MakersAsylumIndia/IS2026_SU_Team12_FootSense/README.md

# Innovation School 2026 Summer Team 12 - FootSense

FootSense is a smart insole system that continuously monitors how weight is distributed across the foot and how each step is taken. Pressure sensors (FSRs) embedded in a gel insole, paired with a motion sensor (IMU) in a compact module, capture real-time gait and balance data. This data is sent wirelessly to a mobile device, where it's analyzed and turned into clear, actionable insights — like incorrect steps per 1000, pressure imbalance, and impact patterns — helping users improve posture, prevent injury, and refine their movement over time.
CAD - No files
Code - Two Versions for the two versions of the project - velostat and flex/piezo sensors
Electronics - Circuit Designs and Pinouts for both versions

## License

Licenses

<a href="LICENSE.md">Open Source Licenses Facts</a>

#### Hardware
CERN Open Hardware License Version 2 - Strongly Reciprocal ([CERN-OHL-S-2.0](https://spdx.org/licenses/CERN-OHL-S-2.0.html)).

#### Software
MIT open source [license](http://opensource.org/licenses/MIT).

#### Documentation:
<br />This work is licensed under a <a rel="license" href="http://creativecommons.org/licenses/by/4.0/">Creative Commons Attribution 4.0 International License</a>.

---
## [OSHWA Certification](https://certification.oshwa.org/list.html)

[OSHW] IN000101 | Certified open source hardware | oshwa.org/cert

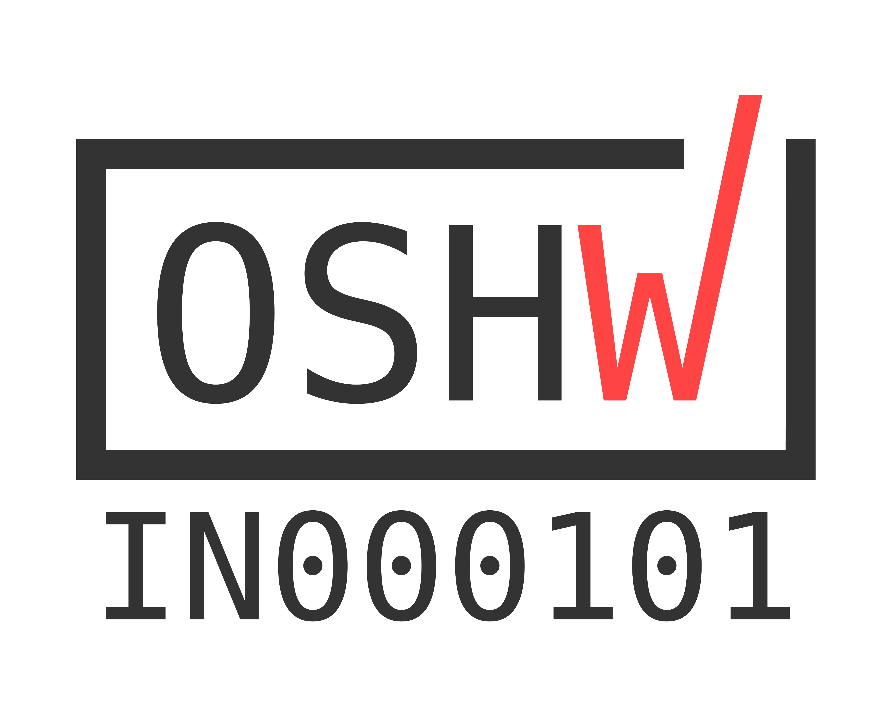
[picture p1: certification-mark-IN000101-stacked.png]


---

## 📬 Contact/Team

> _List team members and contact emails or GitHub profiles._

[Arnav Gupta](https://github.com/arnav0123-blt)

[Kiyansh Mahajan](https://github.com/kiyanshh-123)

[Kinjal Mehta](https://github.com/kinjalmehta24)

[Maker's Asylum](https://github.com/makersasylum)

[@anool](https://github.com/Anool)
>
> ---
