MakersAsylumIndia/IS2026_SU_Team12_FootSense/Documentation/Team12_FootSense.pptx

FootSense

smart insole tracker
A 10 crore rupee problem,
solved with a soldering iron

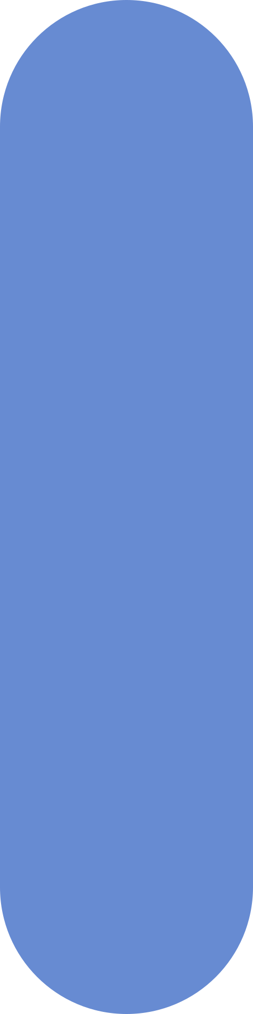
[picture p4: figure]
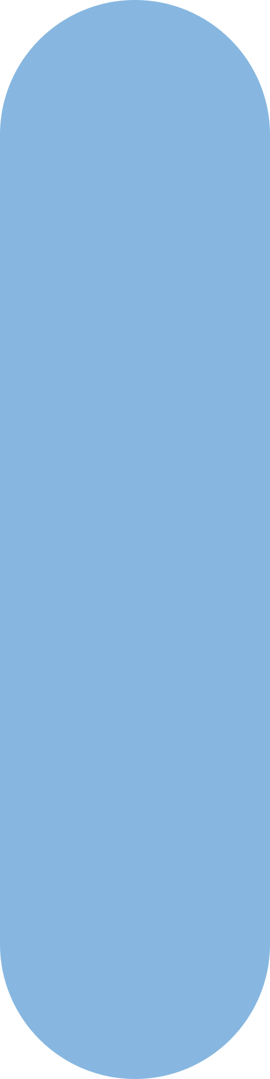
[picture p5: figure]
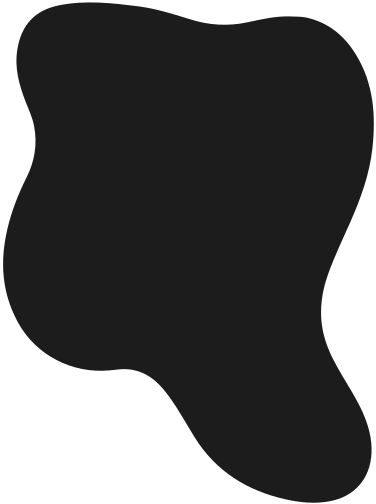
[picture p6: figure]
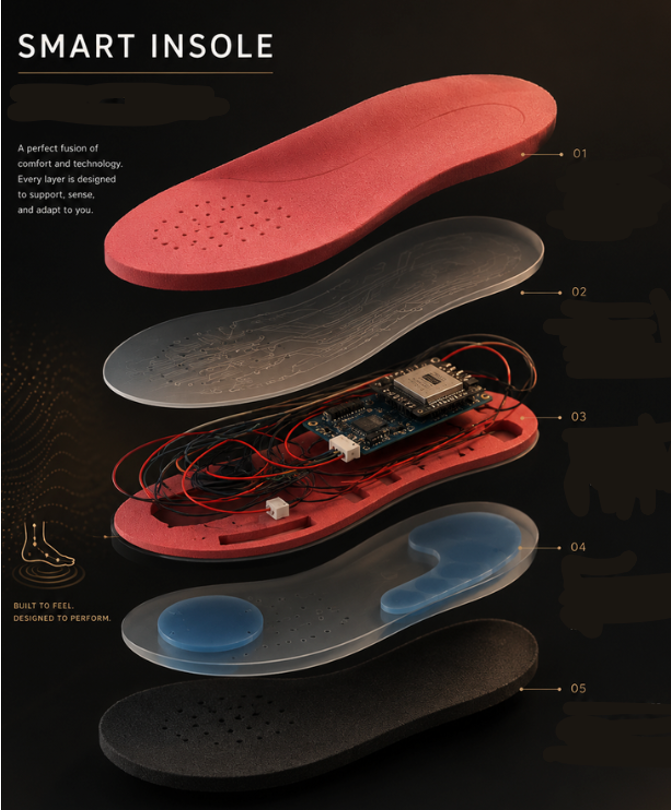
[picture p7: figure]

By: Arnav Gupta
Kinjal Mehta
Kiyansh Mahajan

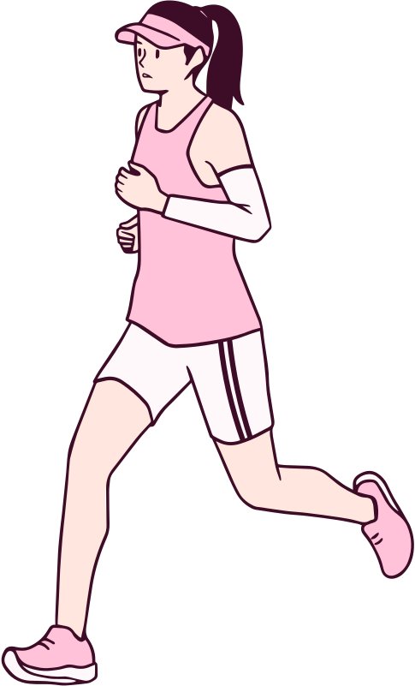
[picture p8: figure]
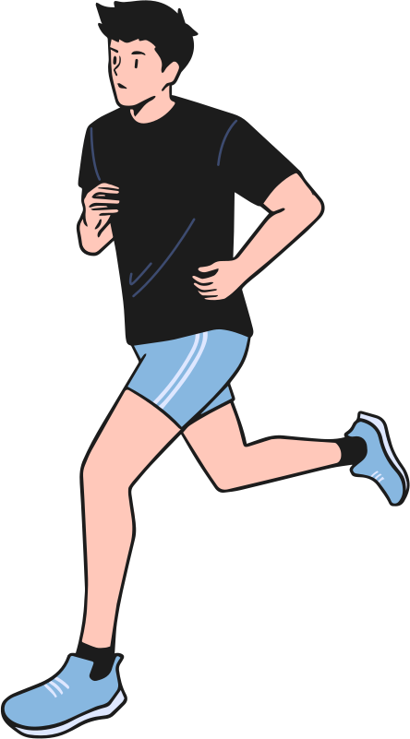
[picture p9: figure]
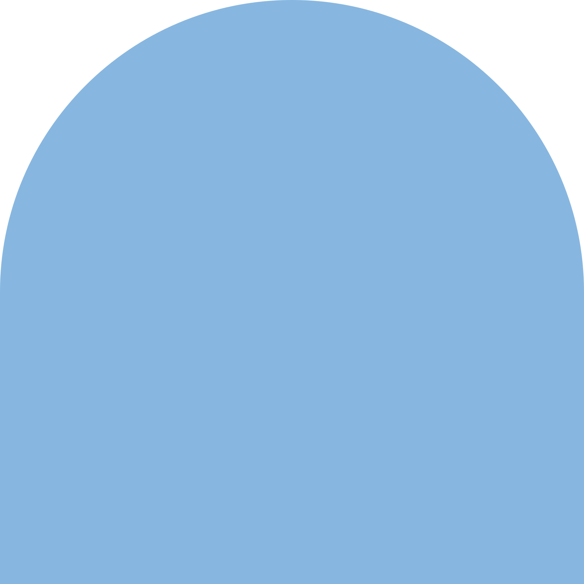
[picture p10: figure]

## Slide 2

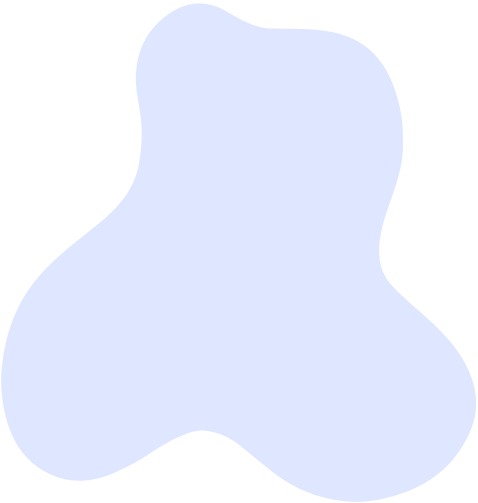
[picture p11: figure]
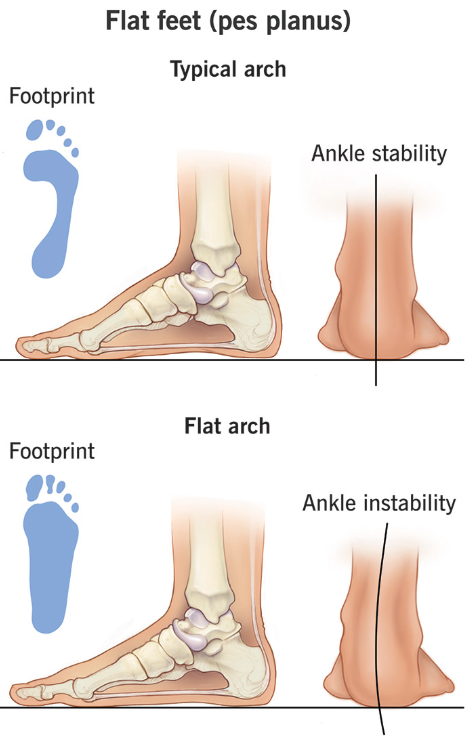
[picture p12: figure]

The Problem

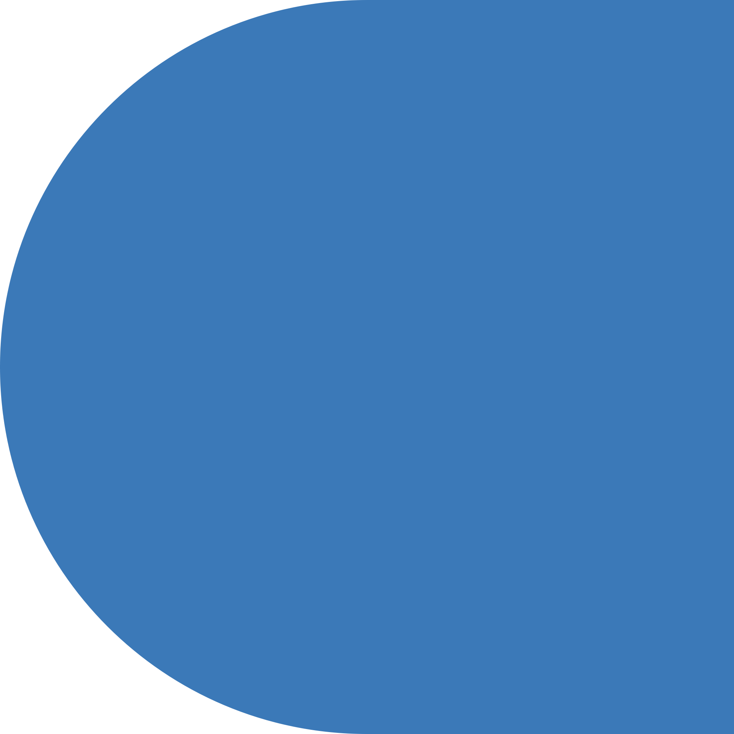
[picture p13: figure]

9–18% of Indians show flat feet, depending on which clinical test you use

One study of traffic police in Gujarat found flat feet in 33–34% of officers — mostly from standing all day

24.8% prevalence found in a Delhi hospital screening study

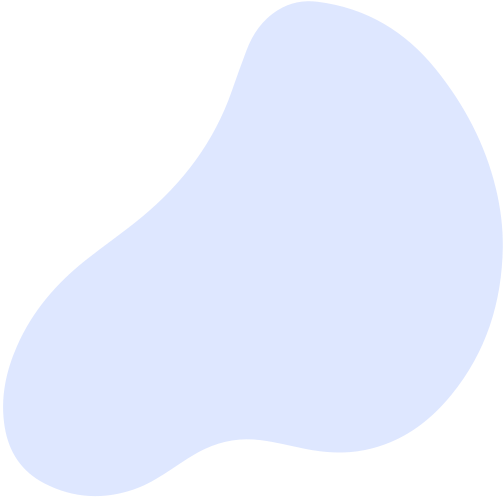
[picture p14: figure]
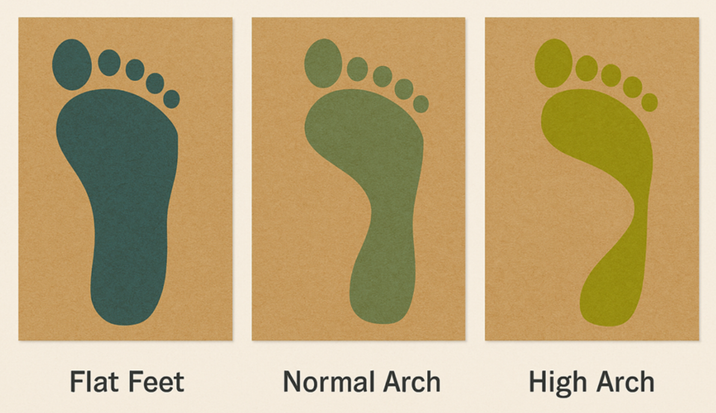
[picture p15: figure]

## Slide 3

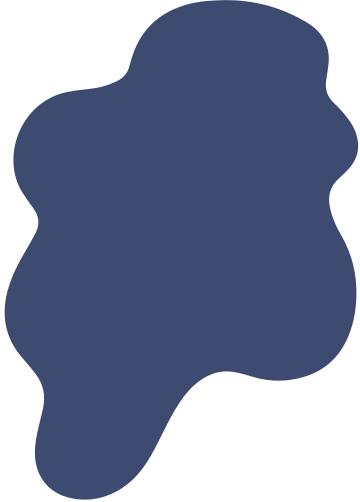
[picture p16: figure]

The Expensive Way

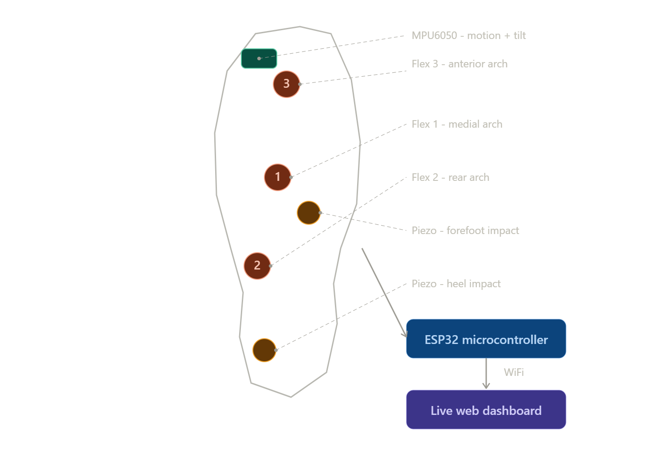
[picture p17: figure]

Clinical Gait Analysis System

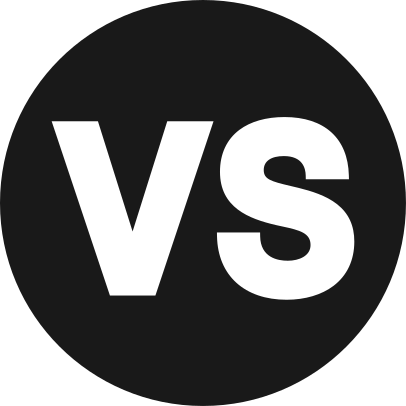
[picture p18: figure]

FootSense

3D Gait Analysis System: ₹10,00,000+
FootSense: a few hundred rupees in sensors and a Sunday at Maker's Asylum

## Slide 4

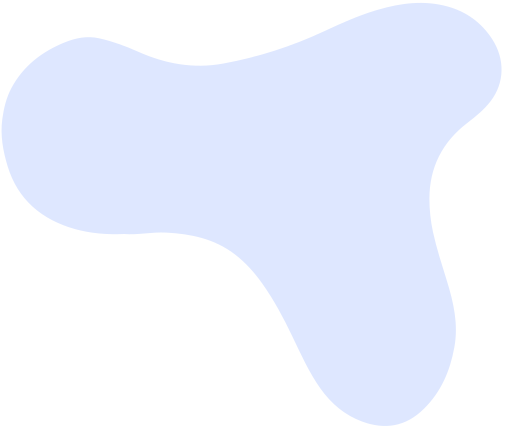
[picture p19: figure]
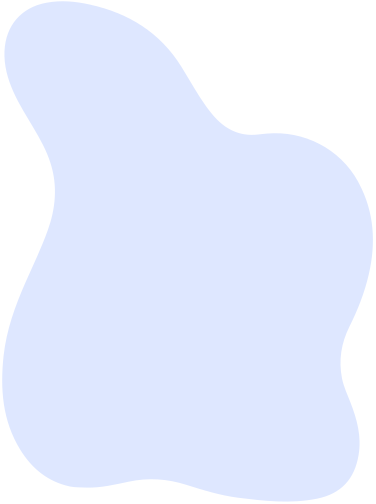
[picture p20: figure]
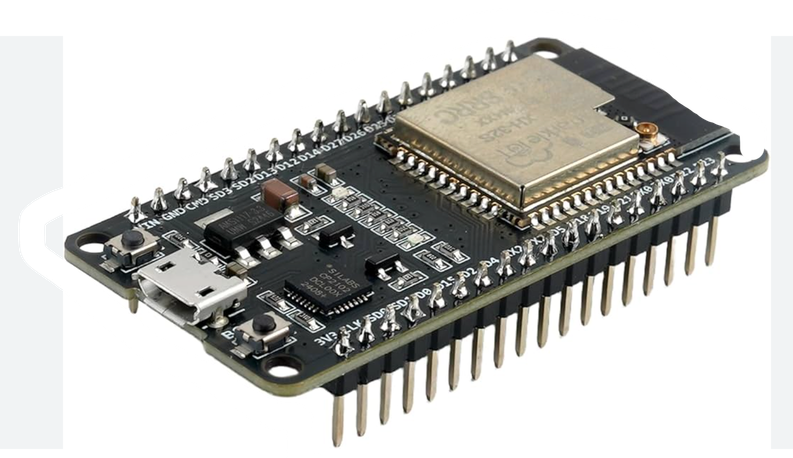
[picture p21: figure]
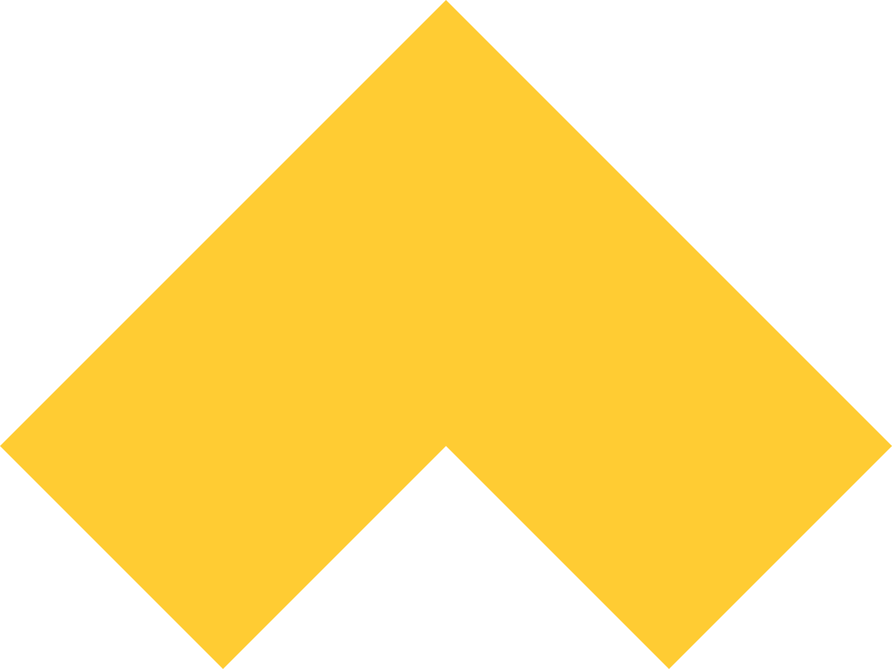
[picture p22: figure]
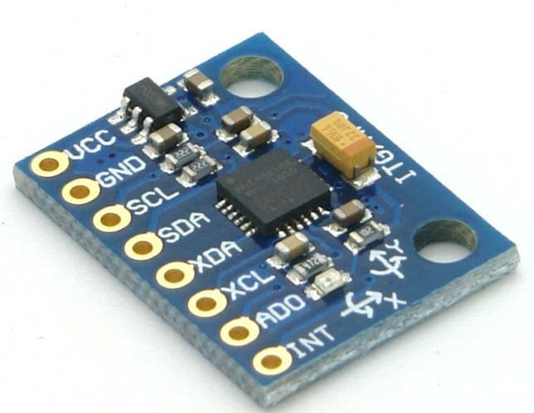
[picture p23: figure]

What’s Actually in the Shoe

  - 3 flex sensors → arch shape (flat / normal / high)
  - 2 piezo discs → heel & forefoot impact
  - MPU6050 → step count & impact angle
  - ESP32 → WiFi → live dashboard

ESP32

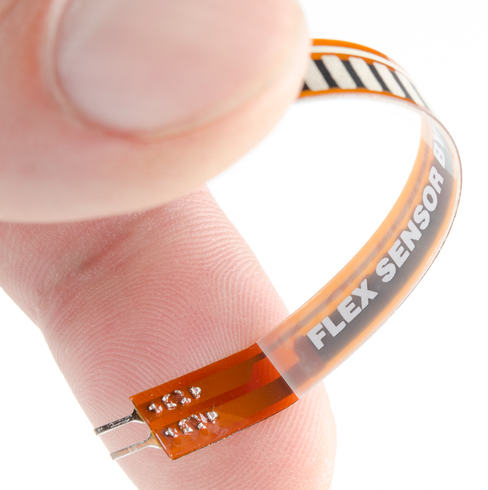
[picture p24: figure]
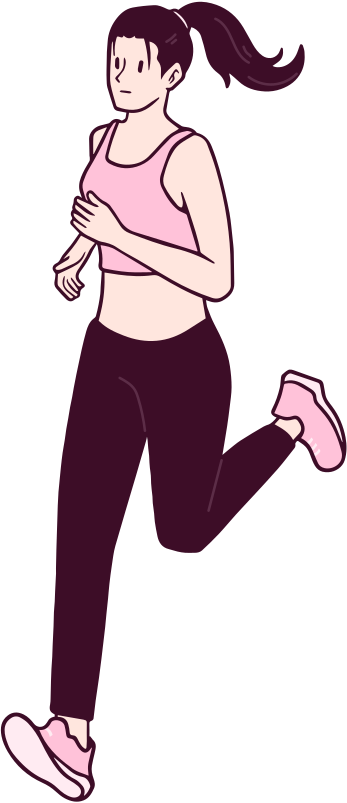
[picture p25: figure]

MPU6050

flex sensor

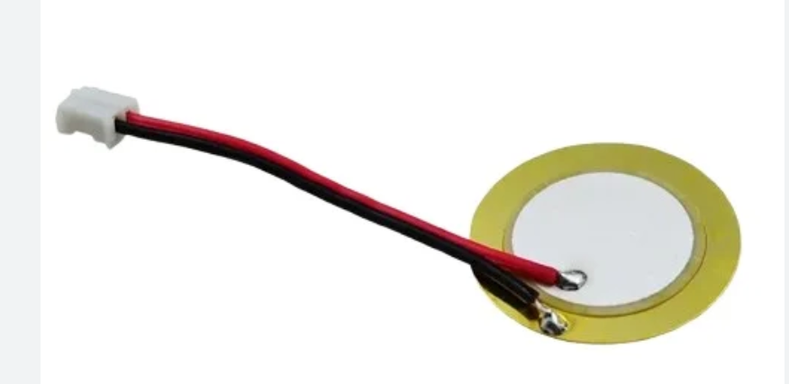
[picture p26: figure]

piezo disc

## Slide 5

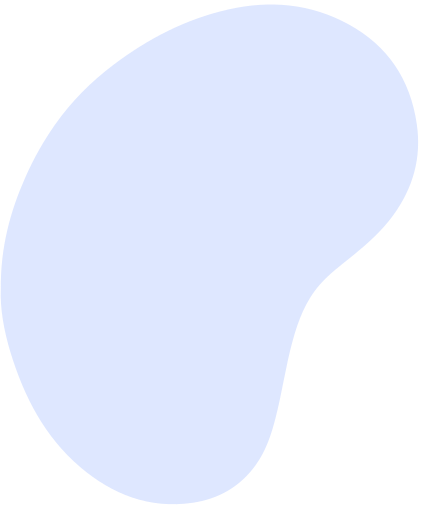
[picture p27: figure]
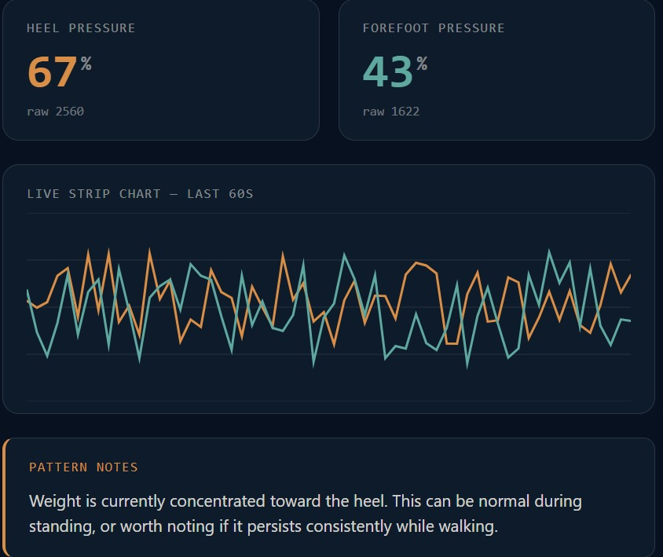
[picture p28: figure]

It Talks Back

Live Dashboard

Real Time Arch Bend

Foot Diagnosis

Impact Pressure (Graph and Data)

Step Count + Impact Angle

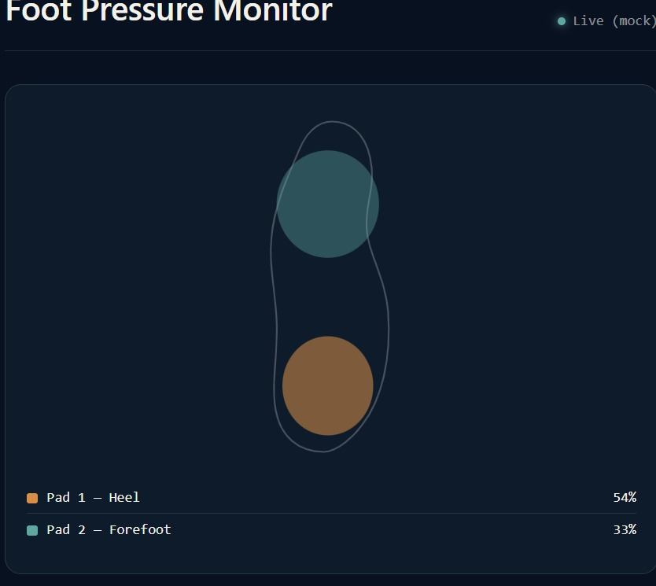
[picture p29: figure]
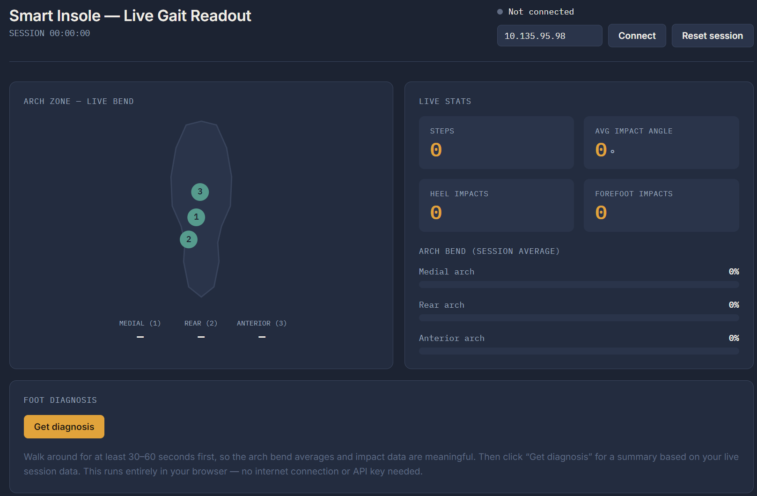
[picture p30: figure]

## Slide 6

## Slide 7

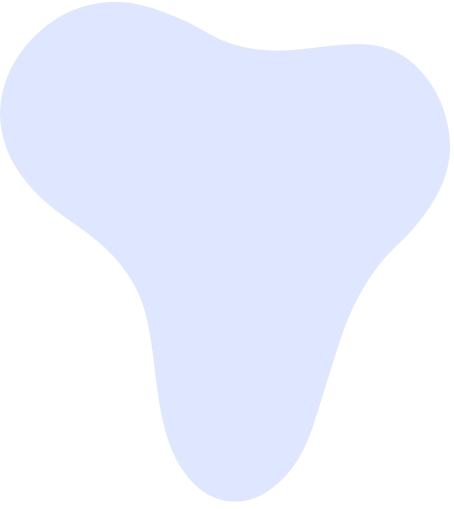
[picture p31: figure]
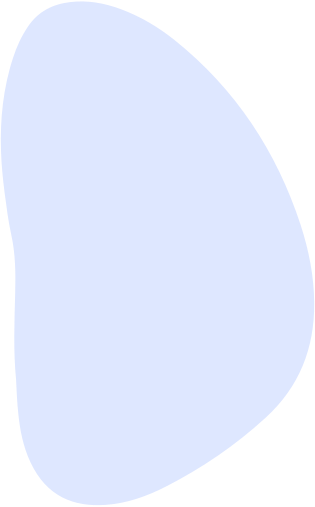
[picture p32: figure]
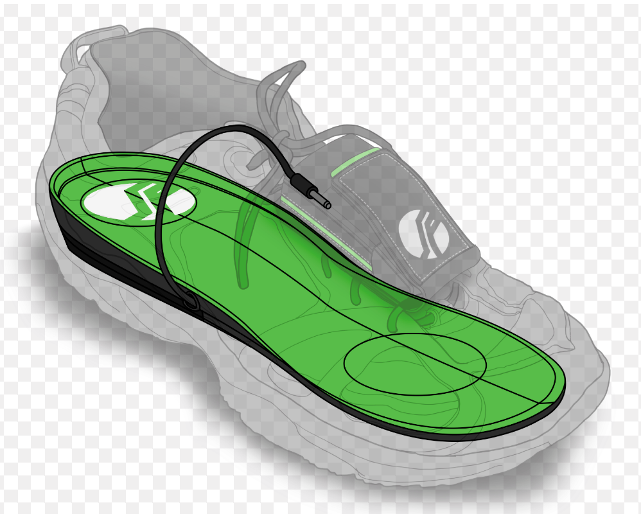
[picture p33: figure]

The Truth

  - Load cell + 4-sensor bridge: didn't work, never fully diagnosed why
  - Switched to flex sensors + piezo discs/velostat instead
  - Chased ghost GPIO pins across three different boards
  - Eventually got a working ESP32 + WiFi + live dashboard pipeline

## Slide 8

The Velostat Version

  - Pressure-sensitive sheet, not discrete sensors
  - Resistance drops the harder you press — wired as a simple voltage divider
  - Gives a continuous pressure map instead of fixed points
  - Closer to what ₹10,00,000 clinical mats actually do
  - Tradeoff: more finicky to calibrate consistently
  - Built in parallel — not a replacement, a second real path

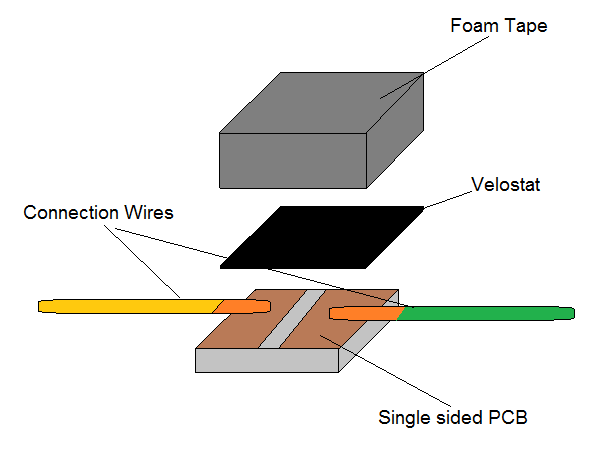
[picture p34: figure]

## Slide 9

The Truth Again

Honest Limitations

  - This is a relative signal, not a medical diagnosis
  - Tested on one person, on one foot.

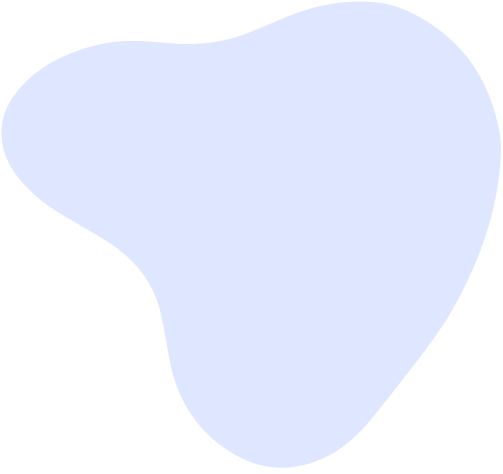
[picture p35: figure]
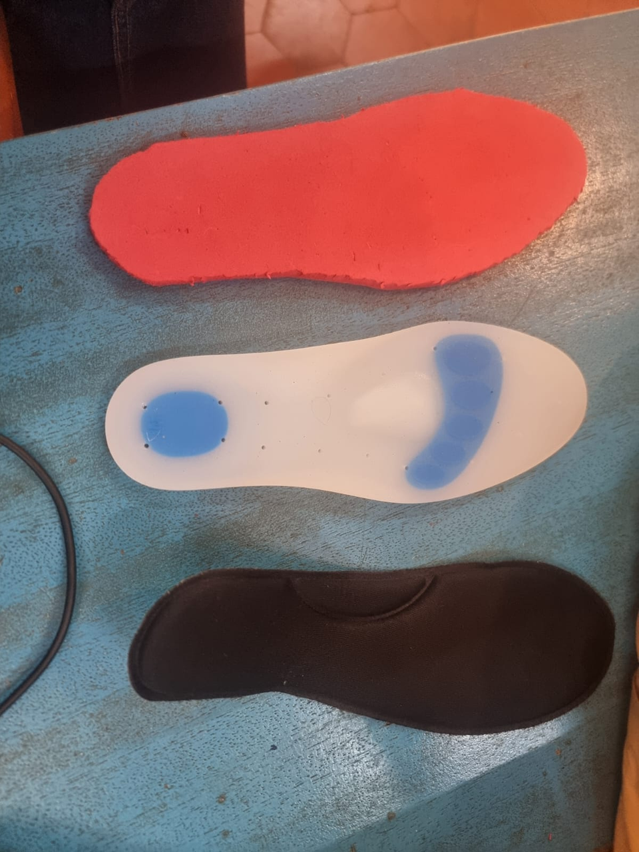
[picture p36: figure]
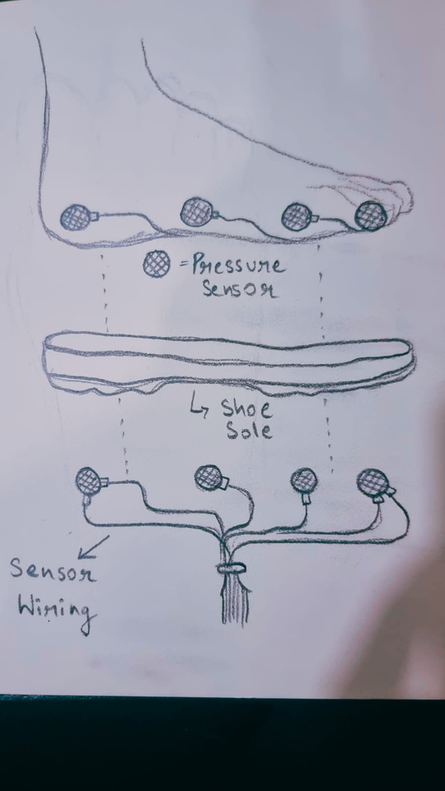
[picture p37: figure]
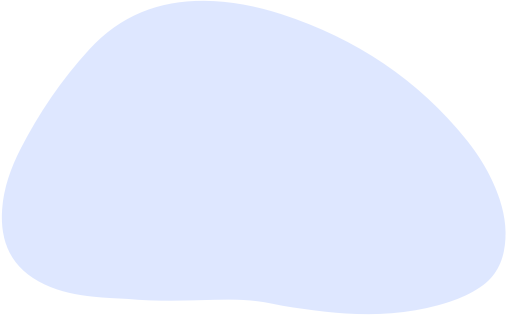
[picture p38: figure]

## Slide 10

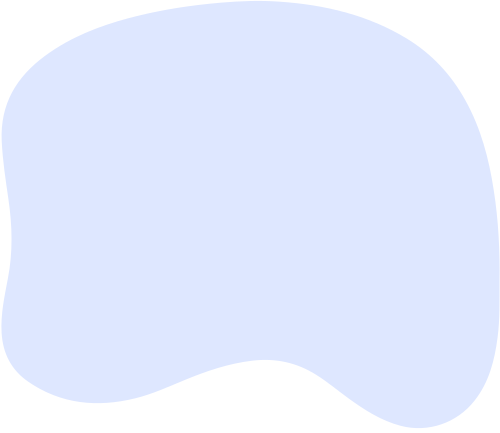
[picture p39: figure]

Roadmap

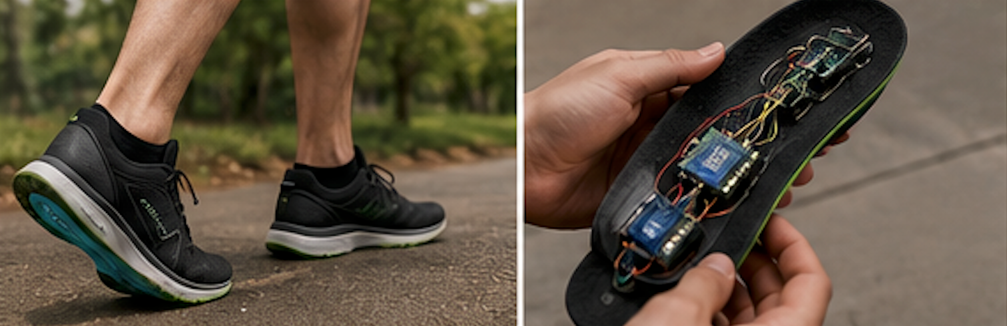
[picture p40: figure]

Q1 Development

Finalize innovative product design and successfully complete precise sensor calibration process. Design a finalised protected prototupe and apply for a license,

Q2 Testing

Testing the product and collecting data. Doing further extensive research and training a neural network to develop an AI/ML finished software. Connect with doctors, share the data and use their feedback.

Q3 Awareness

Launch the product on a small scale, connect with shoe/footwear giants and look to expand the product’s functionality and make more iterations.

## Slide 11

FootSense

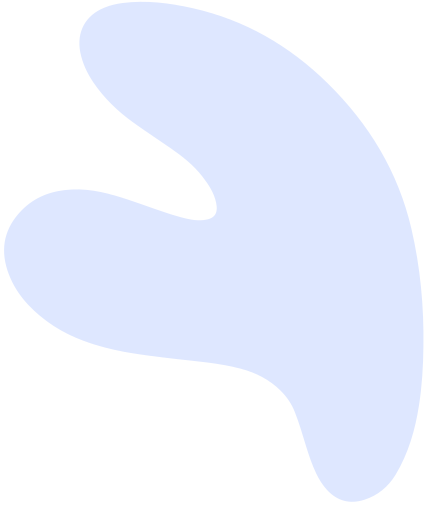
[picture p41: figure]
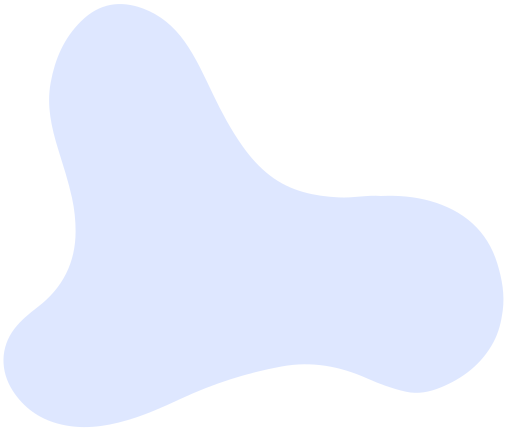
[picture p42: figure]

Lab-grade insight. Maker-grade budget. Blood. Sweat. Tears. A LOT of work. Even more help from mentors.
Questions?

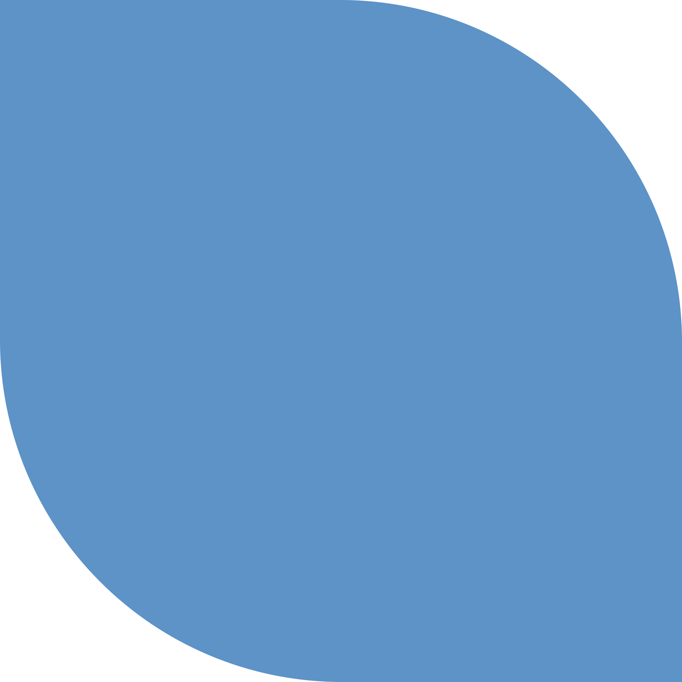
[picture p43: figure]

## Slide 12

People We Want to Thank

The amazing teammates we had here.
The ENTIRE Maker Team:
Dakshat Sir
Anool Sir
Vaibhav Sir
Miss Amber
Miss Sushmita
Sahil Sir
Miss Richa
Sankalp
Kinshuk
Sovam
Gunjan
All Our friends here, and Makers Asylum

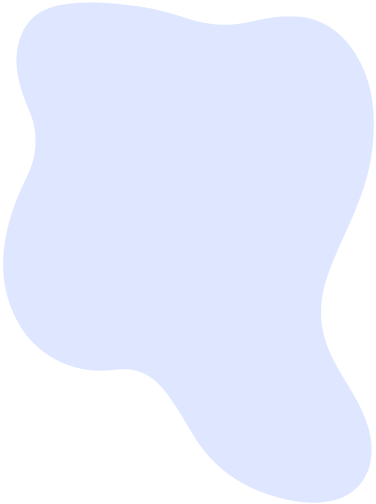
[picture p44: figure]

Simran
Adishi
Shyam
Bhoomika
Arjun
Jastin / Kalki 01
Sebi

for watching and always supporting us

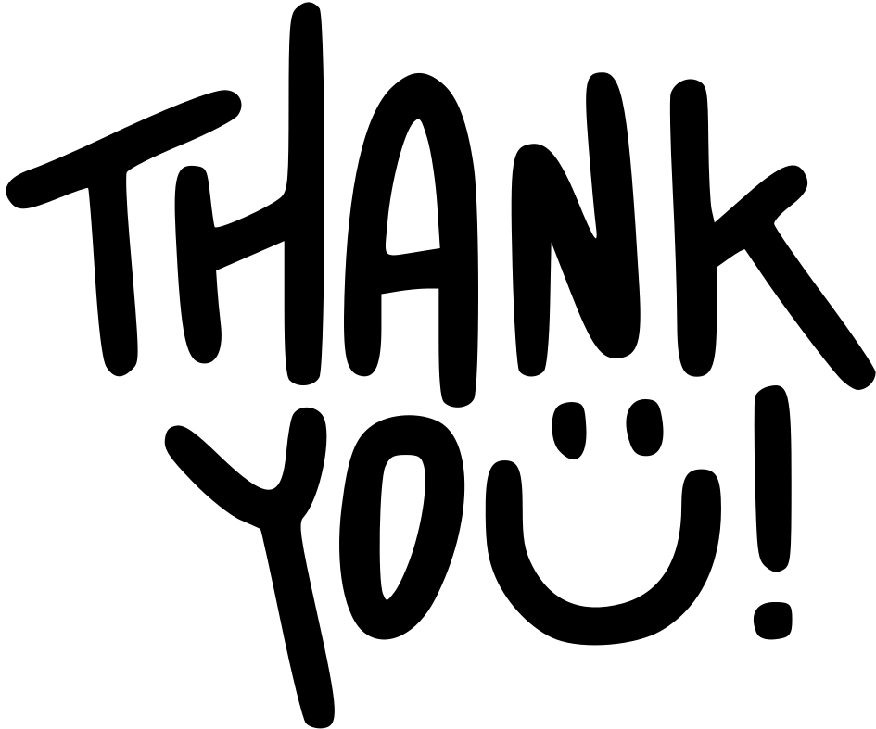
[picture p45: figure]
