MakersAsylumIndia/IS2026_SU_Team12_FootSense/Electronics/PinOuts/FlexSensor PinOut.webp

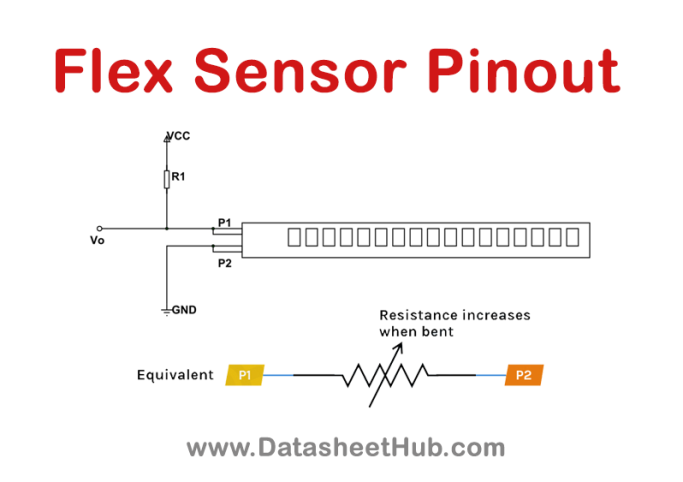
Electronics/PinOuts/FlexSensor PinOut.webp
