MakersAsylumIndia/IS2026_SU_Team12_FootSense/Electronics/PinOuts/MPU6050IMU PinOut.png

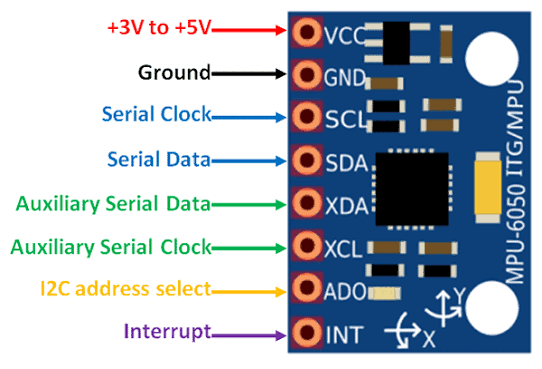
Electronics/PinOuts/MPU6050IMU PinOut.png
