MakersAsylumIndia/IS2026_SU_Team12_FootSense/Electronics/PinOuts/PiezoPinOut.png

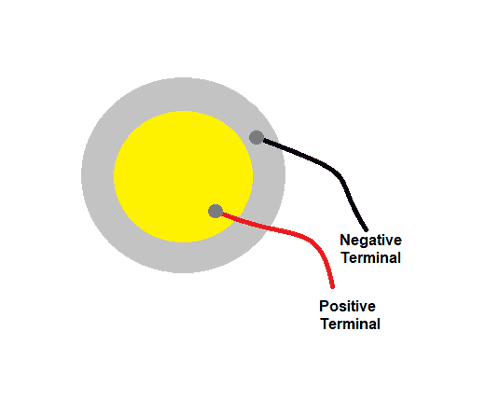
Electronics/PinOuts/PiezoPinOut.png
