MakersAsylumIndia/IS2026_SU_Team12_FootSense/Electronics/PinOuts/Velostat PinoUt.png

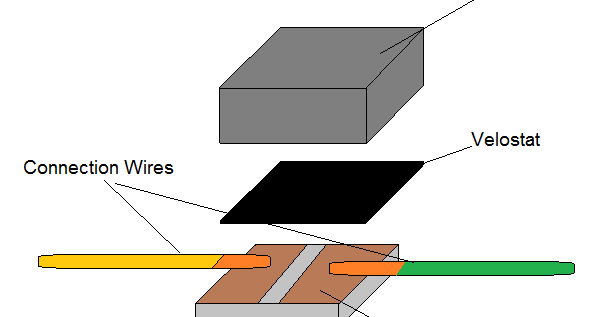
Electronics/PinOuts/Velostat PinoUt.png
