MakersAsylumIndia/IS2026_SU_Team12_FootSense/Electronics/Velostat Circuit/arduino nano cirkitdesign velostat.jpeg

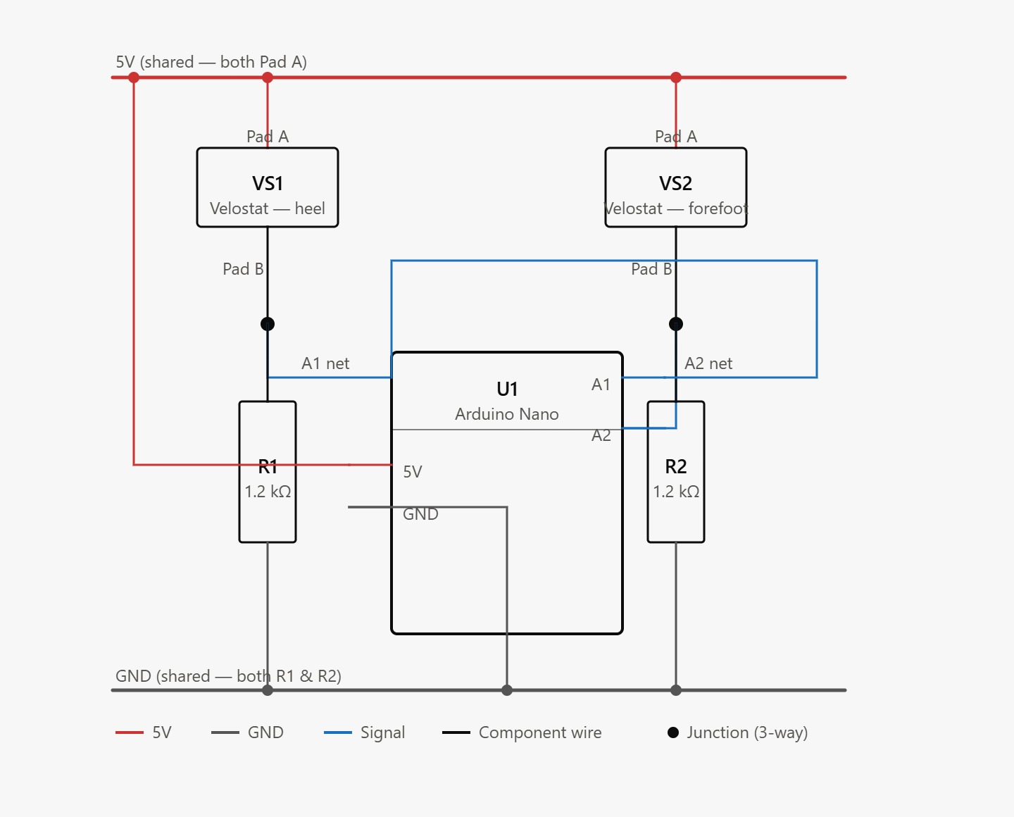
Electronics/Velostat Circuit/arduino nano cirkitdesign velostat.jpeg
