MakersAsylumIndia/IS2026_SU_Team12_FootSense/Electronics/Velostat Circuit/esp32 cirkitdesign velostat.jpeg

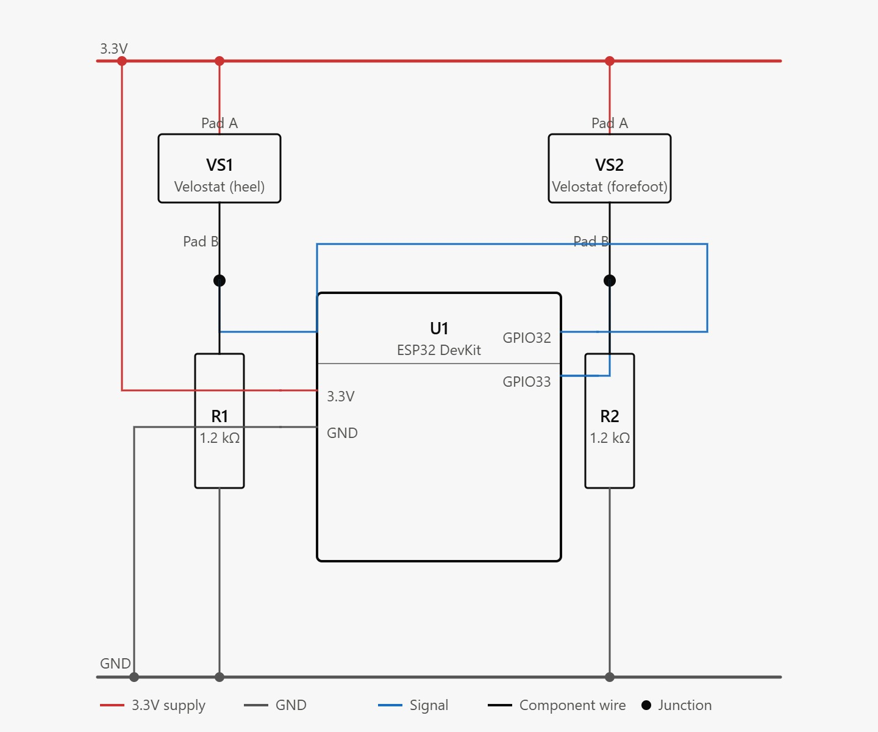
Electronics/Velostat Circuit/esp32 cirkitdesign velostat.jpeg
