MakersAsylumIndia/IS2026_SU_Team12_FootSense/Photos_Videos/Images/Team12_FootSense_03.jpeg

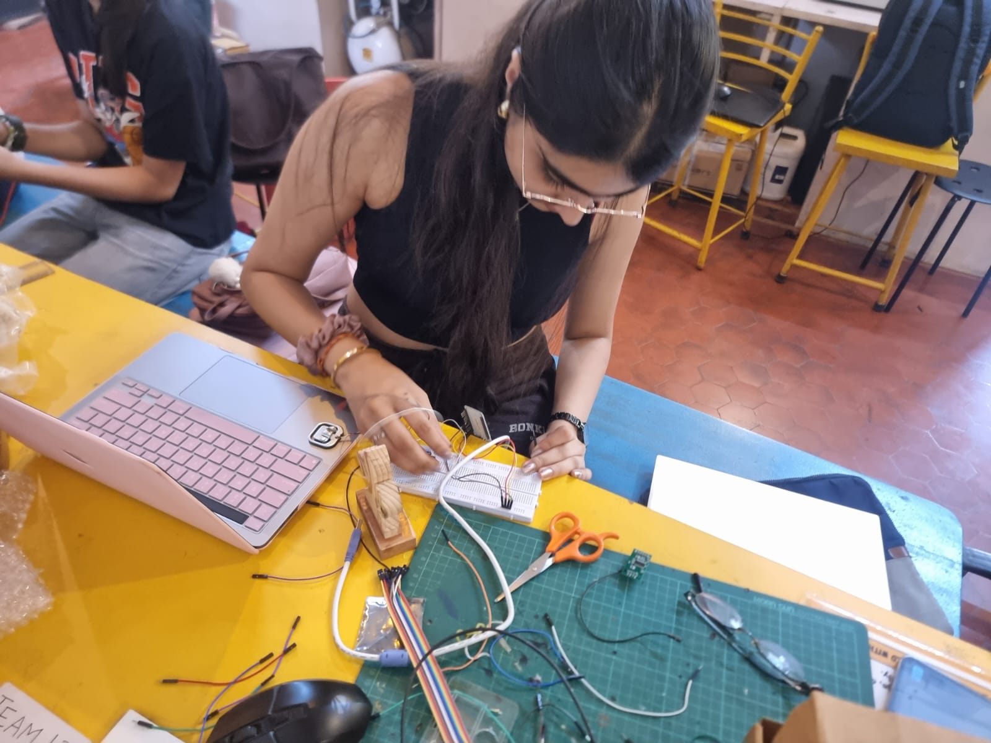
Photos_Videos/Images/Team12_FootSense_03.jpeg
