MakersAsylumIndia/IS2026_SU_Team12_FootSense/Documentation/Team12_FootSense.pdf

# FootSense

## smart insole tracker

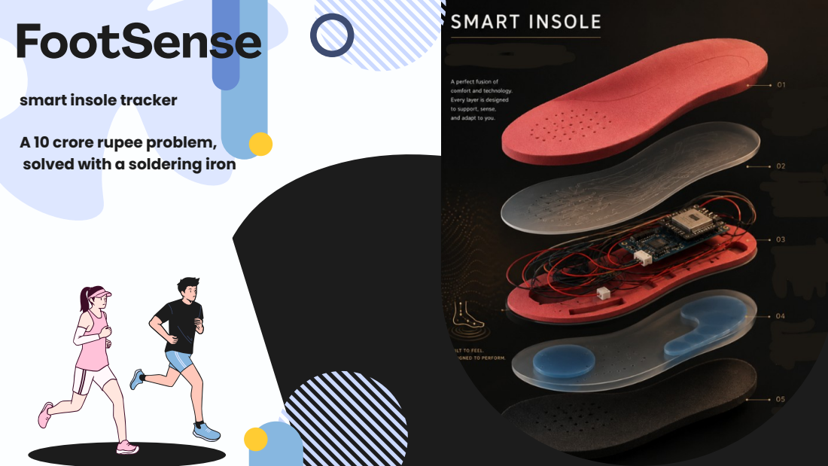
[picture p64: page 1]

A 10 crore rupee problem,
solved with a soldering iron

By: Arnav Gupta
Kinjal Mehta
Kiyansh Mahajan

# The Problem

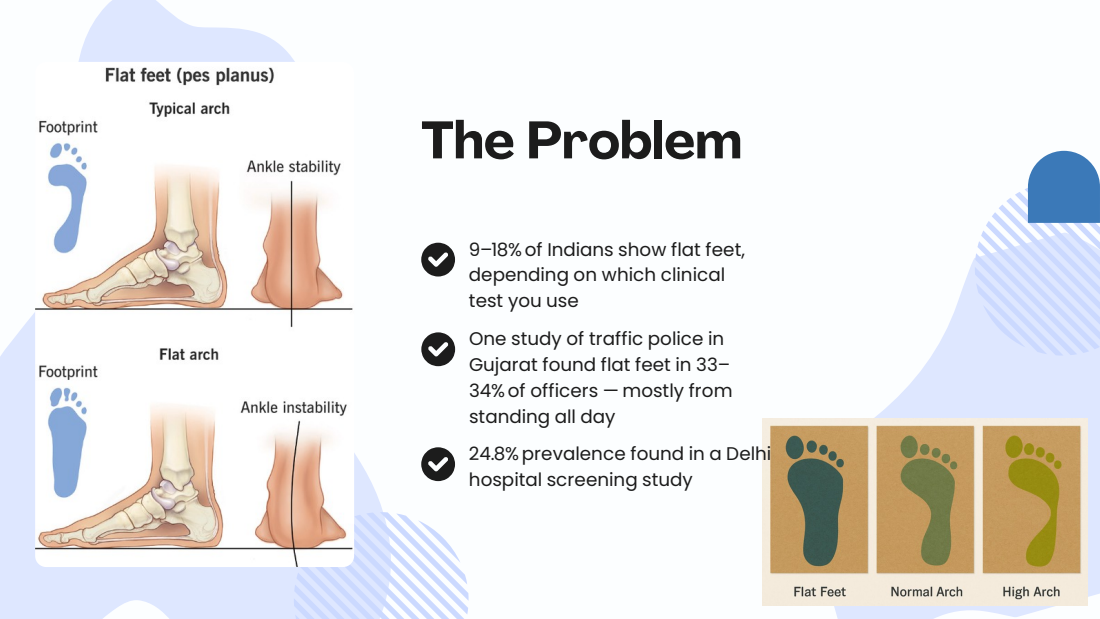
[picture p65: page 2]
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

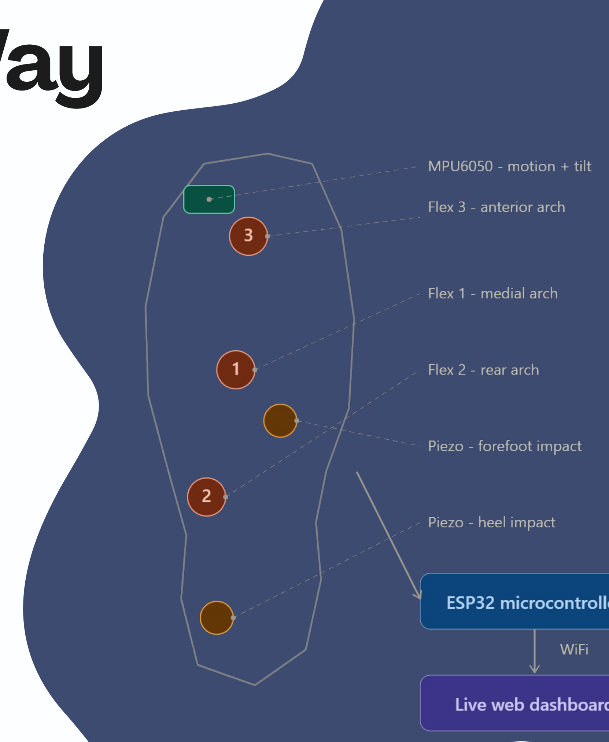
[picture p66: figure]

# The Expensive Way

# Clinical Gait Analysis System

# FootSense

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

# What’s Actually

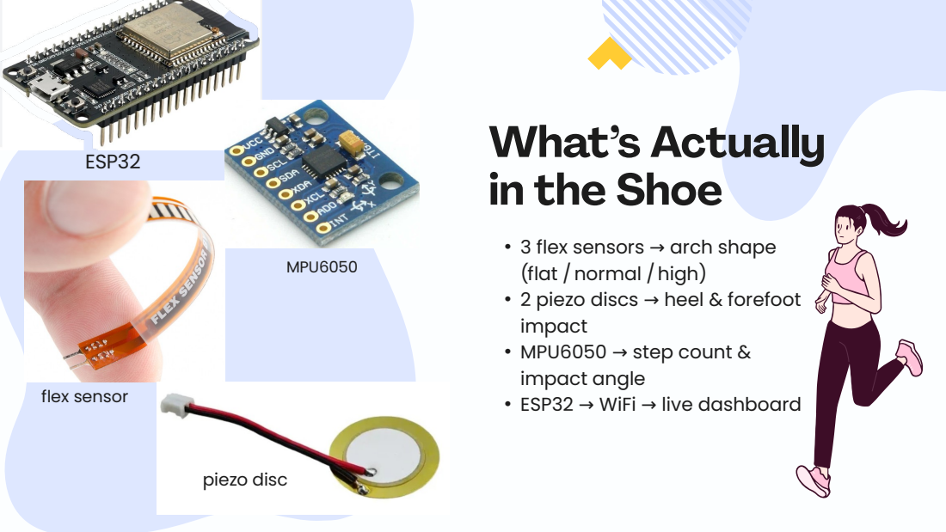
[picture p67: page 4]
• ESP32 WiFi live dashboard →; ESP32; MPU6050; flex sensor; piezo disc

in the Shoe

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

# It Talks Back

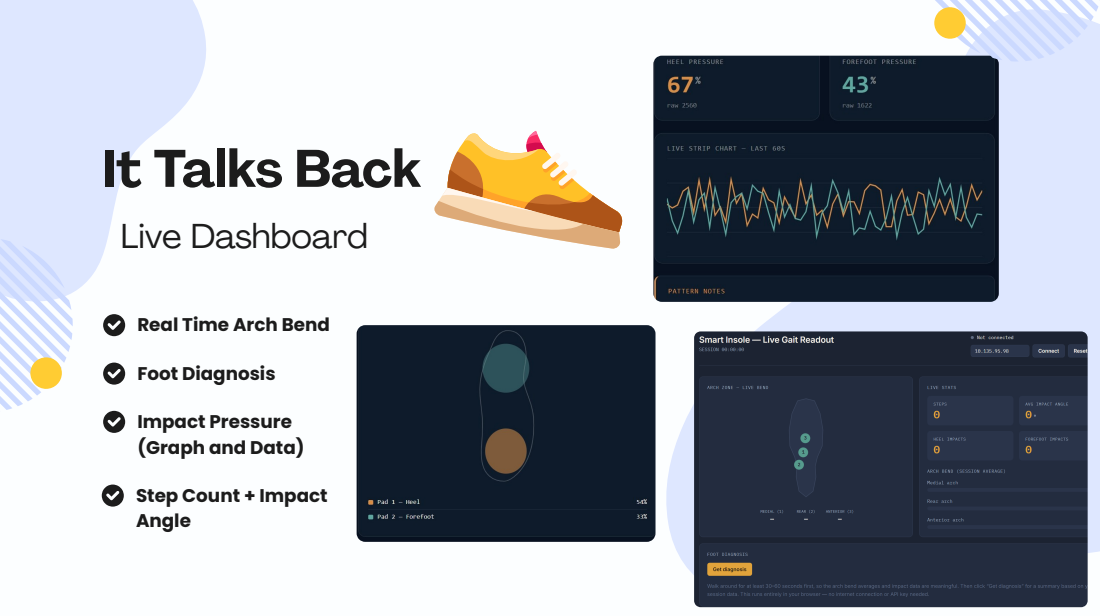
[picture p68: page 5]
Live Dashboard

Real Time Arch Bend
Foot Diagnosis
Impact Pressure
(Graph and Data)
Step Count + Impact
Angle

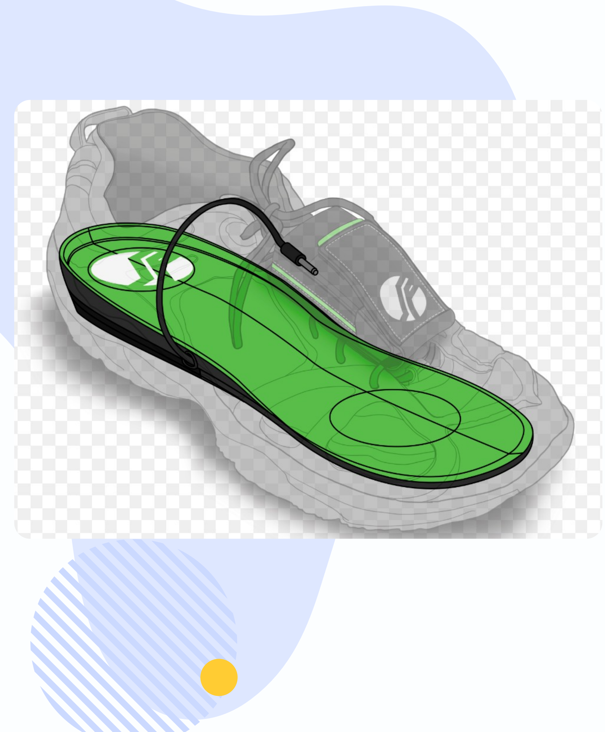
[picture p69: figure]

# The Truth

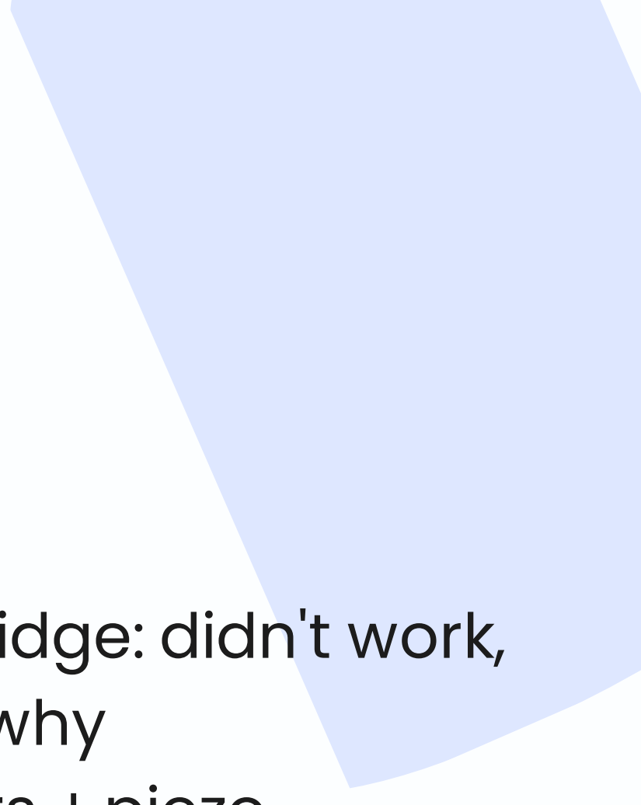
[picture p70: figure]

- Load cell + 4-sensor bridge: didn't work,

## never fully diagnosed why - Switched to flex sensors + piezo discs/velostat instead - Chased ghost GPIO pins across three different boards - Eventually got a working ESP32 + WiFi + live dashboard pipeline

## - Pressure-sensitive sheet, not discrete sensors - Resistance drops the harder you press —

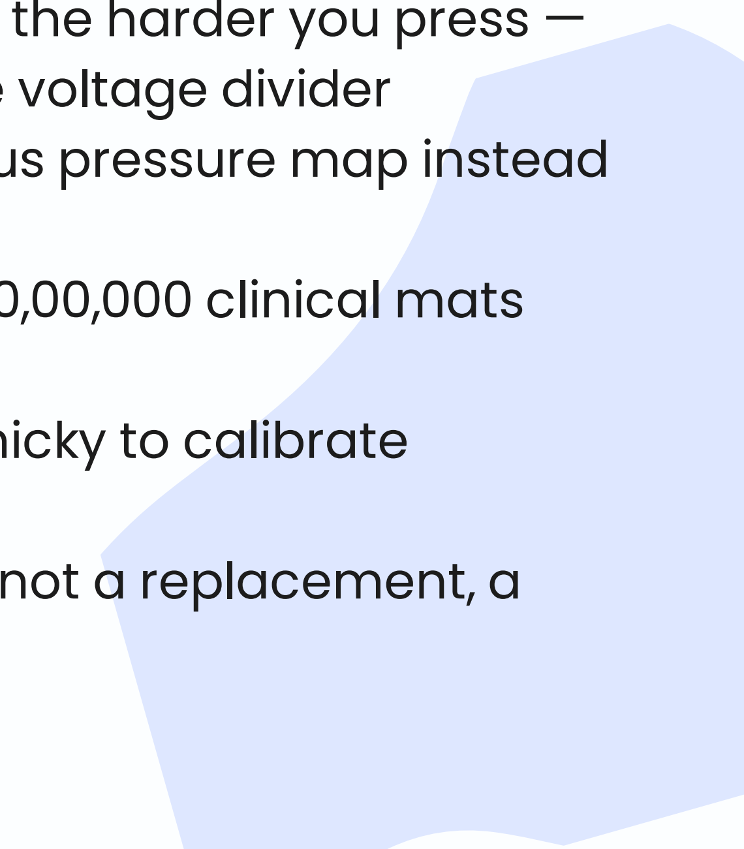
[picture p71: figure]

## wired as a simple voltage divider - Gives a continuous pressure map instead of fixed points - Closer to what ₹10,00,000 clinical mats actually do - Tradeoff: more finicky to calibrate consistently - Built in parallel — not a replacement, a second real path

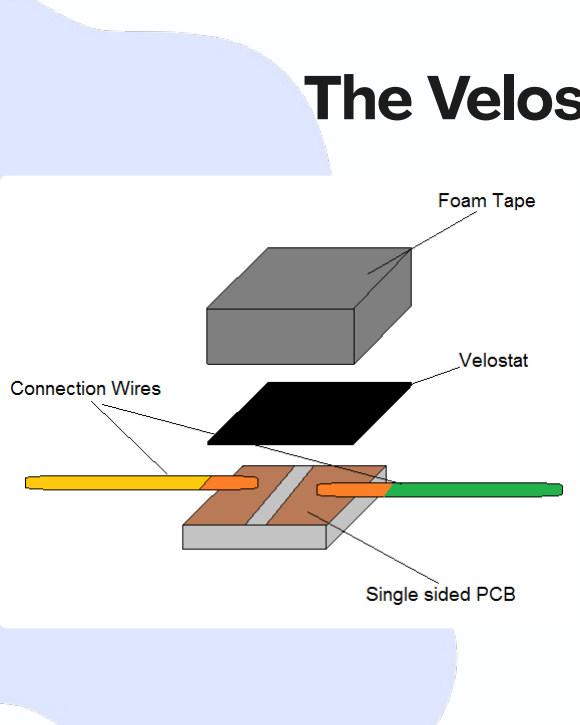
[picture p72: figure]

# The Velostat Version

# The Truth Again

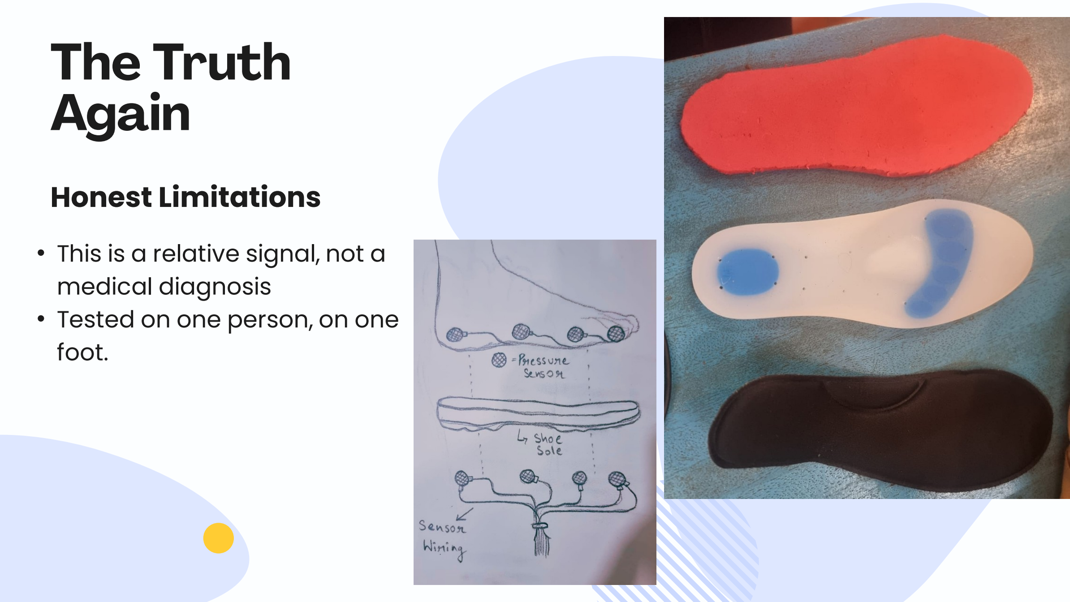
[picture p73: page 9]

## - This is a relative signal, not a medical diagnosis - Tested on one person, on one

foot.

# Honest Limitations

# Roadmap

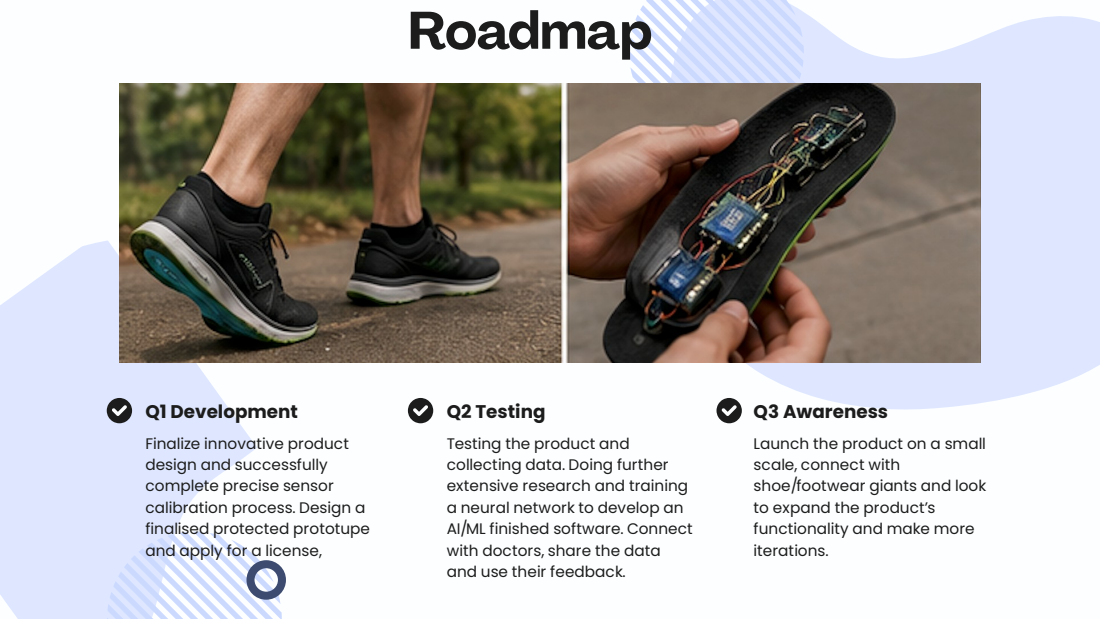
[picture p74: page 10]
Q2 Testing; Q3 Awareness

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

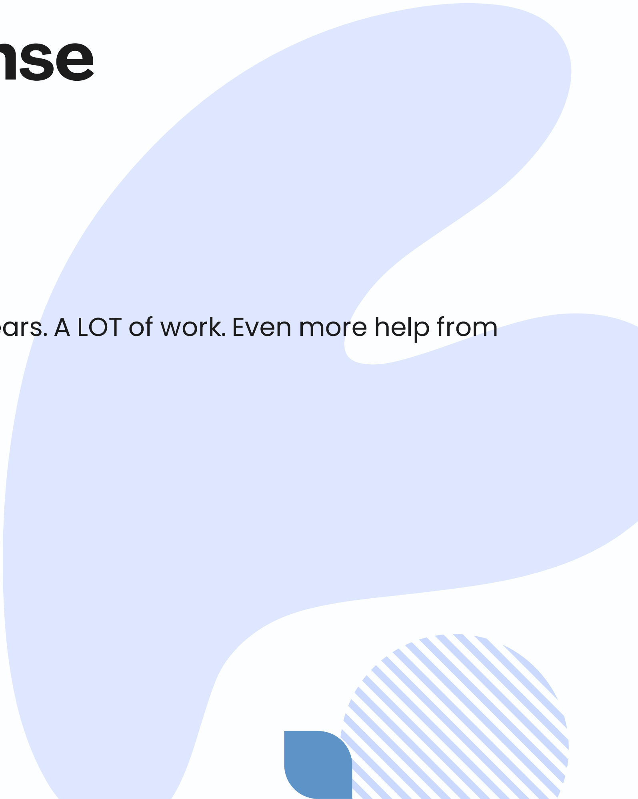
[picture p75: figure]
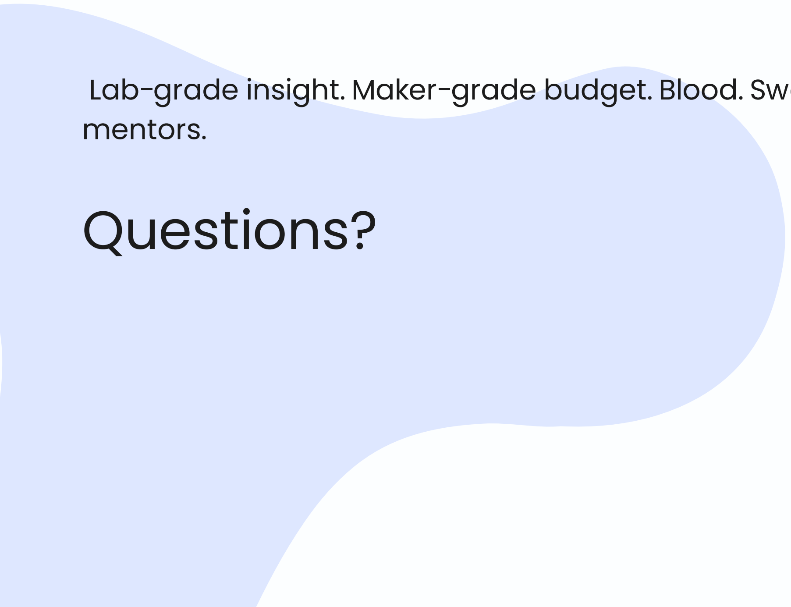
[picture p76: figure]
mentors. Questions?

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

# FootSense

# People We Want to Thank

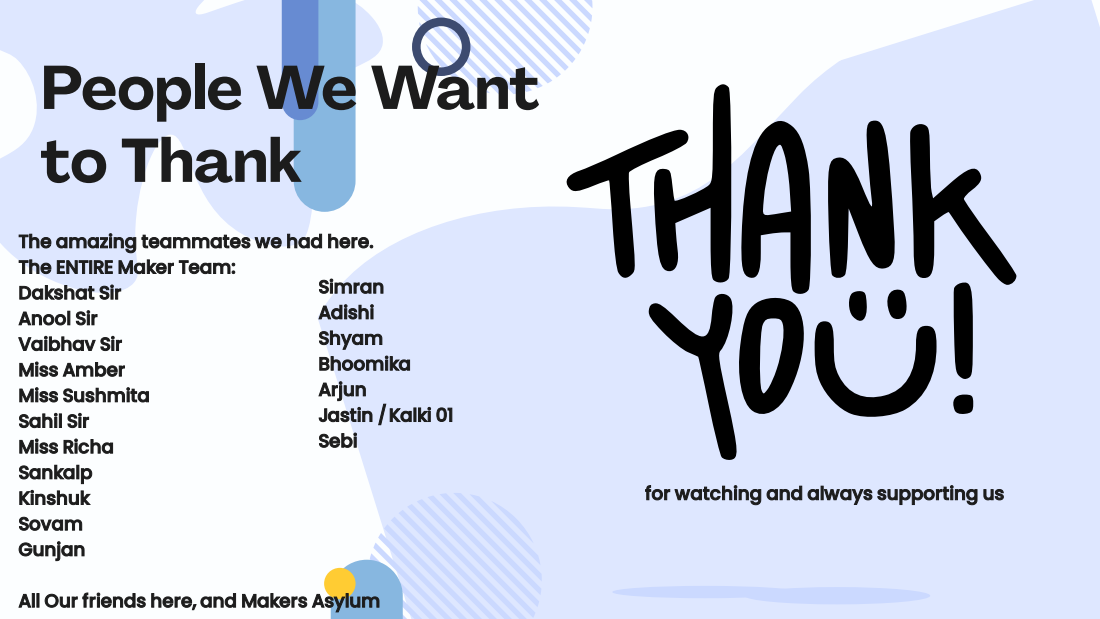
[picture p77: page 12]
Simran Adishi Shyam Bhoomika Arjun Jastin / Kalki 01 Sebi

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

for watching and always supporting us
