MakersAsylumIndia/IS2026_SU_Team12_FootSense/(commit log)

2026-06-25 Updated Individual Sensor Names - Codes yet to be uploaded
2026-06-25 Individual Sensor Codes
2026-06-25 Fixed formatting and uploaded test codes
    [flex_sensor_esp32.ino, mpu6050_esp32.ino, piezo_esp32.ino]
2026-06-25 Updated CAD Info
2026-07-22 Create Sensor - CirkitDesigner Final.png
2026-07-24 updated circuit designs
2026-07-31 Update and rename WIRING.md to README.md
2026-07-31 Update images in README for FootSense Circuit
    Swapped images for the breadboard and simplified versions of the FootSense Circuit.
